jungdaehan11/amr-ros2-slam/maps/my_real_map.png

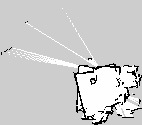
maps/my_real_map.png
