jungdaehan11/amr-ros2-slam/docs/calibration.xlsx

AMR 개루프 캘리브레이션 — 속도 ↔ PWM 대응표
0x15 연속PWM 명령 (int8 x2 = 실제 PWM). onset=int8 80. 바닥·부하 상태에서 측정.
노란 칸(거리)만 채우면 속도 자동계산. 각 값 2~3회 측정 후 평균 거리 입력 권장.
① 직진 속도 측정
int8 값 | 실제 PWM | 측정시간(s) | 이동거리(m) | 속도(m/s) | 비고(쏠림 등)
80 | 160 | 3 |  | 0.000
90 | 180 | 3 |  | 0.000
100 | 200 | 3 |  | 0.000
110 | 220 | 3 |  | 0.000
120 | 240 | 3 |  | 0.000
127 | 254 | 3 |  | 0.000
② 좌우 트림 확인 (같은 int8인데 휘면 좌우 모터 특성차)
기준 int8 | 좌 편향? | 우 편향? | 보정 필요량 | 메모
100
③ 요약 (자동/수기)
최소 구동 int8 (onset) | 80 | static 기준. 이보다 작으면 안 움직임 → 브릿지 데드존 보상 기준값
최대 int8 | 127 | int8 상한 (PWM 254)
최저 속도 (m/s) | 0.000 | int8 80에서의 속도
최고 속도 (m/s) | 0.000 | int8 127에서의 속도
