jungdaehan11/amr-ros2-slam/(commit log)

2026-09-06 라즈베리파이 세팅 + ROS2 Jazzy 설치
2026-09-12 docs: 3-A WSL2+ROS2 원격 RViz2 시각화 세팅 가이드 추가
2026-09-12 feat: 4단계 첫 SLAM 지도 (slam_toolbox + rf2o, 손으로 매핑)
2026-09-12 docs: 4단계 완료 인수인계 문서 (3-B 시작 시점)
2026-09-18 feat: 3-B C++ 브릿지 노드 (cmd_vel→아두이노 패킷, Packet 재사용, termios 시리얼)
2026-09-18 4단계 개루프 캘리브레이션 완료: 0x15 연속PWM + 데드존/부스트/트림, HANDOVER5
    [calibration.xlsx]
2026-10-03 feat: MPU-6050 IMU 통합 및 robot_localization EKF 센서 퓨전
2026-10-03 feat: 실주행 SLAM 지도 생성 (4단계 완료)
2026-10-03 docs: HANDOVER6 갱신 - 4단계 완료 (실주행 SLAM 지도)
2026-10-05 feat: Nav2 자율주행 - 회전후직진 중재, 전역 inflation 분리, AMCL 정지중 보정
2026-10-06 docs: README 업데이트 - 센서 퓨전, Nav2 자율주행, 트러블슈팅 기록
